anthonydiiorio/LZ1AQ-Loop-Controller/(threads)

Thread 3 (2022-08-09):

4th relay control

mandonych, 2022-08-09:
Thanks for making this project.
I find it very useful and easy to make. I made one for myself and had the idea to turn off the amplifier when the antenna is not in use. I control an antenna that is located in another building over a local network.
Is it possible to make independent control of the fourth relay, because it is not used? Add another button or switch (On/Off) to control it. It could be used to cut off power from the amplifier's power supply when the antenna is not in use. Of course, your code is not so complicated, with detailed comments, but unfortunately my knowledge is not enough for this. I can only edit the code to build it in Visual Studio Code.

anthonydiiorio, 2022-08-10:
Hi Alex, thanks for the suggestion. I've implemented an option to control the 4th relay.

Relay 4 connects to pin D1 (GPIO 5)
You can enable the 4th relay by setting `bool auxEnable = true;`
You can set the button label by changing `const char *auxLabel = "Relay 4";`

mandonych, 2022-08-10:
Awesome, thanks for the quick response. This is exactly what I needed. I hope this will also be useful to someone.

anthonydiiorio, 2022-08-10:
Thanks, yup I just wired my unit to control the power supply as well. I added an option to set the button colors for normally closed as well.

You can invert the button color for normally closed by setting `bool auxNC = true;`

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

Closed 2022-08-10.
