anthonydiiorio/LZ1AQ-Loop-Controller/(commit log)

2019-12-15 Bill of Materials
2019-12-15 Update nodemcu-loop-controller.ino
    Holdover from prototype
2019-12-15 Schematic Diagram
2020-06-12 Update LZ1AQ-Loop-Controller.ino
    Whoops, no wonder it didn't work 😛
    [LZ1AQ-Loop-Controller.ino]
2022-01-11 Fix mDNS
    Wow can't believe I missed this one. Old router worked with hostnames so I thought it was working all along.
    [LZ1AQ-Loop-Controller.ino]
2022-08-10 Add support for auxiliary relay
    Added support for controlling the 4th relay using pin D1 (GPIO 5)
2022-08-10 Option to invert aux button colors
    [LZ1AQ-Loop-Controller.ino]
